Udu007/Automatic-Wire-Cutter/Hardware/wire_feeder_shaft.stl

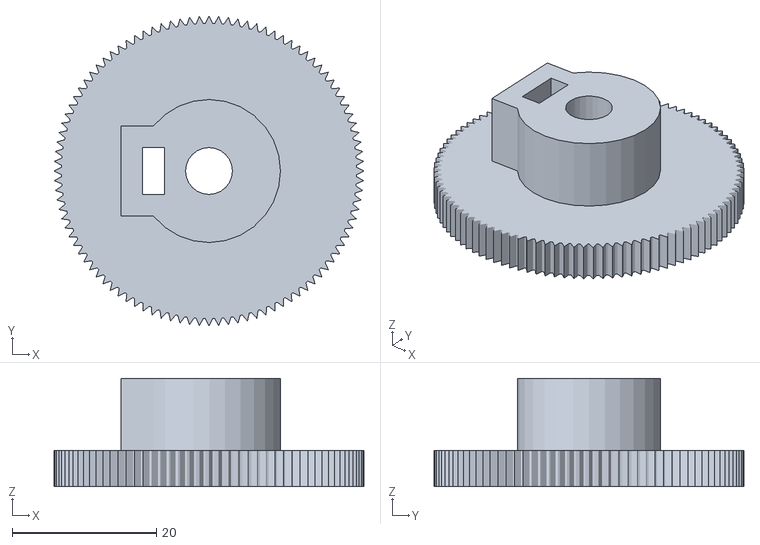
[picture p1: CAD file, 2026-06-25]
Hardware/wire_feeder_shaft.stl
43.0 x 43.0 x 15.0
