Udu007/Automatic-Wire-Cutter/Hardware/supporter.stl

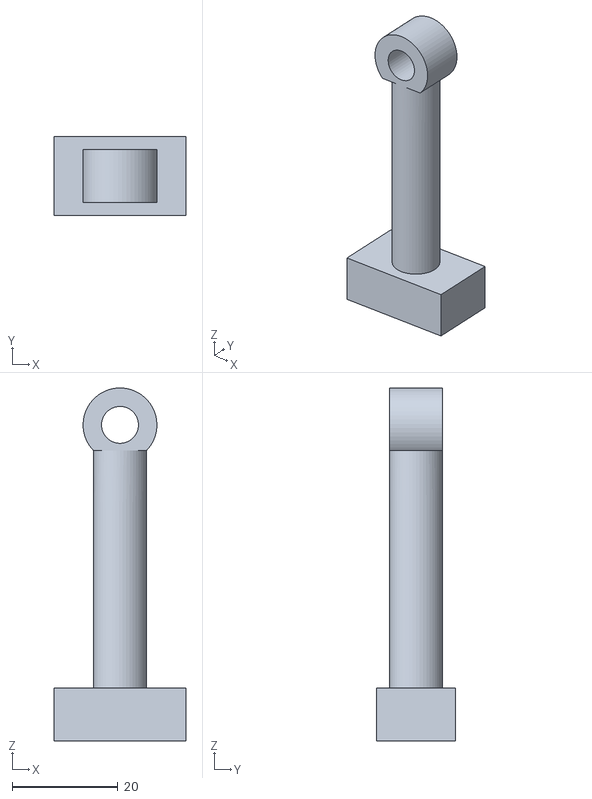
[picture p2: CAD file, 2026-06-25]
Hardware/supporter.stl
25.0 x 15.0 x 66.9
