Udu007/Automatic-Wire-Cutter/Hardware/wire_feeder_part2.stl

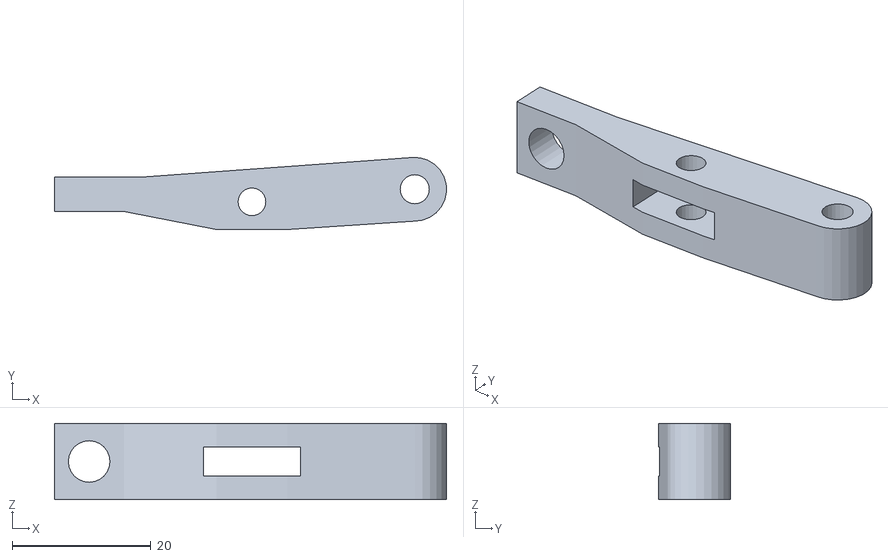
[picture p3: CAD file, 2026-06-25]
Hardware/wire_feeder_part2.stl
56.6 x 10.4 x 11.0
