Udu007/Automatic-Wire-Cutter/Hardware/Servo Guide.stl

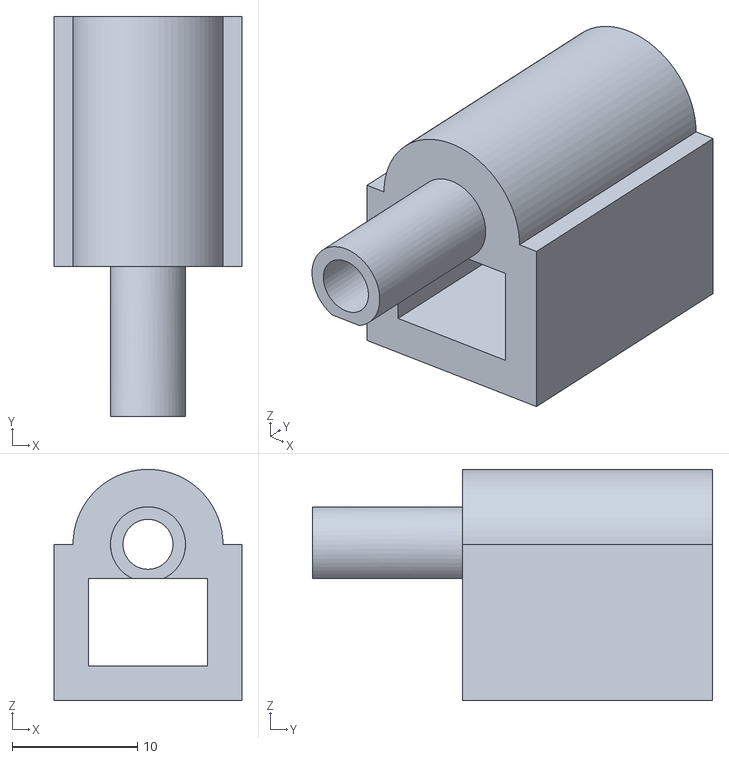
[picture p4: CAD file, 2026-06-25]
Hardware/Servo Guide.stl
15.0 x 32.0 x 18.5
