Udu007/Automatic-Wire-Cutter/Hardware/Wire Cutter Base Stand.stl

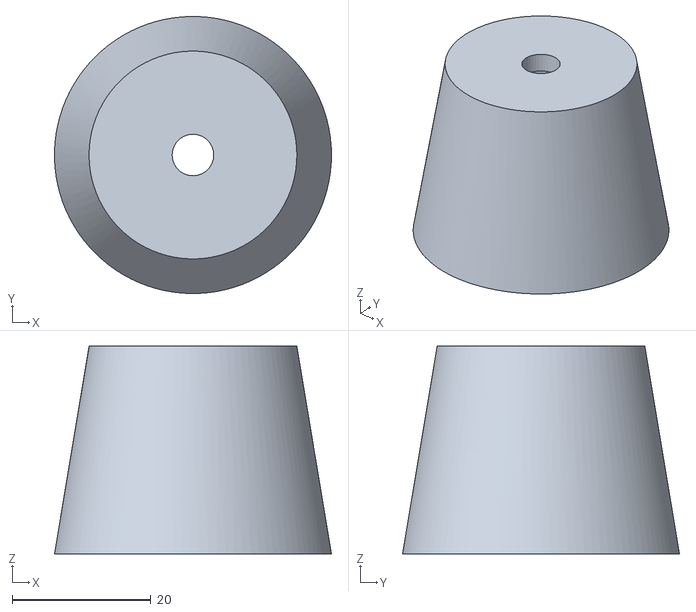
[picture p5: CAD file, 2026-06-25]
Hardware/Wire Cutter Base Stand.stl
40.0 x 40.0 x 30.0
