Udu007/Automatic-Wire-Cutter/Hardware/cutter_puller.stl

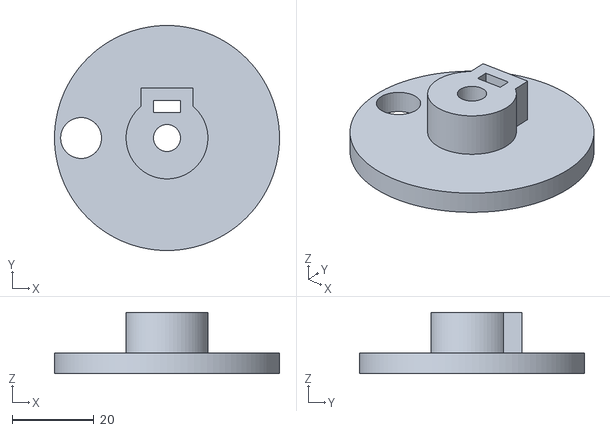
[picture p6: CAD file, 2026-06-25]
Hardware/cutter_puller.stl
55.0 x 55.0 x 15.0
