Udu007/Automatic-Wire-Cutter/Hardware/Wire Cutter Stand.stl

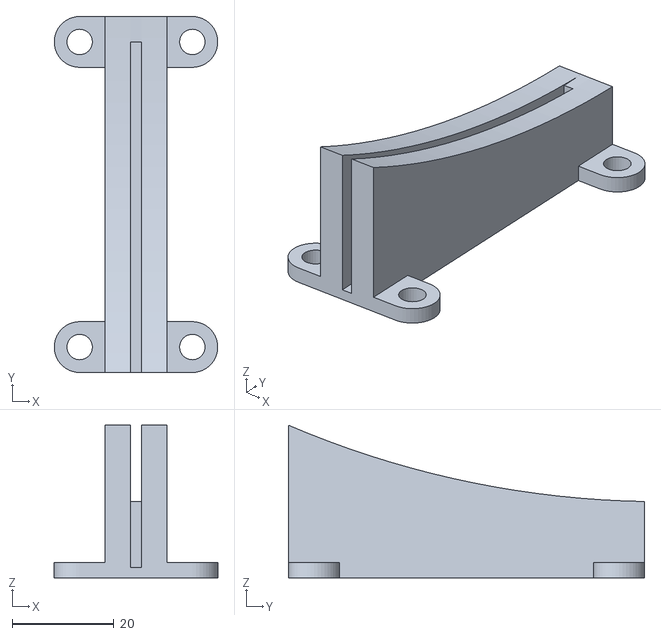
[picture p7: CAD file, 2026-06-25]
Hardware/Wire Cutter Stand.stl
32.2 x 70.0 x 30.0
