Udu007/Automatic-Wire-Cutter/Hardware/SMPS Stand.stl

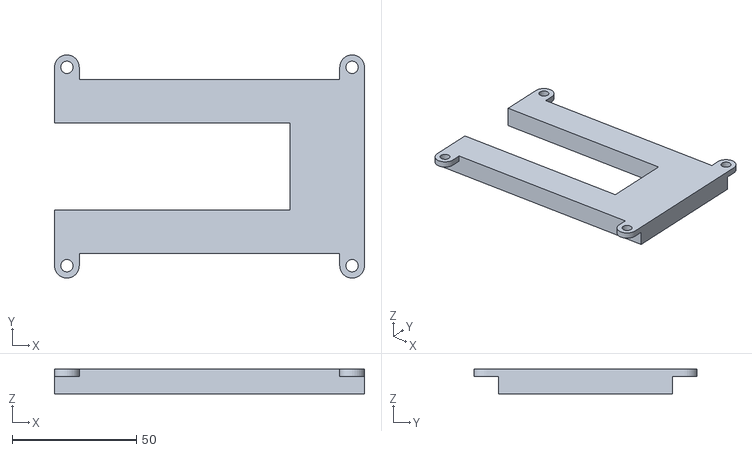
[picture p8: CAD file, 2026-06-25]
Hardware/SMPS Stand.stl
125.0 x 90.0 x 10.0
