Udu007/Automatic-Wire-Cutter/Hardware/Wire Puller Shaft.stl

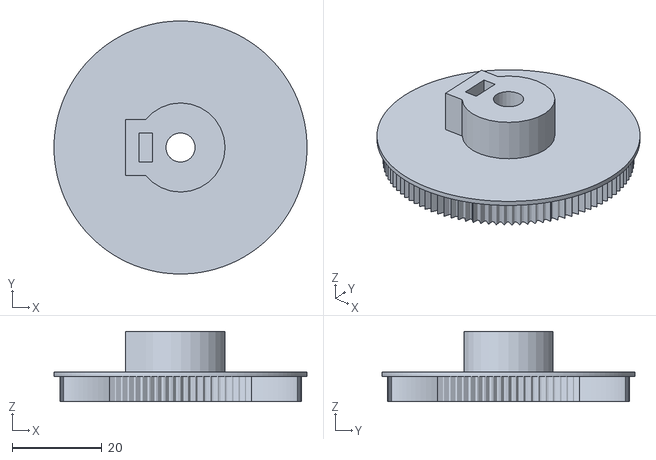
[picture p9: CAD file, 2026-06-25]
Hardware/Wire Puller Shaft.stl
56.3 x 56.3 x 15.6
