Udu007/Automatic-Wire-Cutter/(list of files, cad)

Other CAD files:
Hardware/Full Project.f3d
Hardware/SMPS Stand.f3d
Hardware/Wire Cutter Base Stand.f3d
Hardware/Wire Cutter Stand.f3d
Hardware/servo part.f3d
