Udu007/Automatic-Wire-Cutter/Hardware/Servo Guide Drawing.pdf

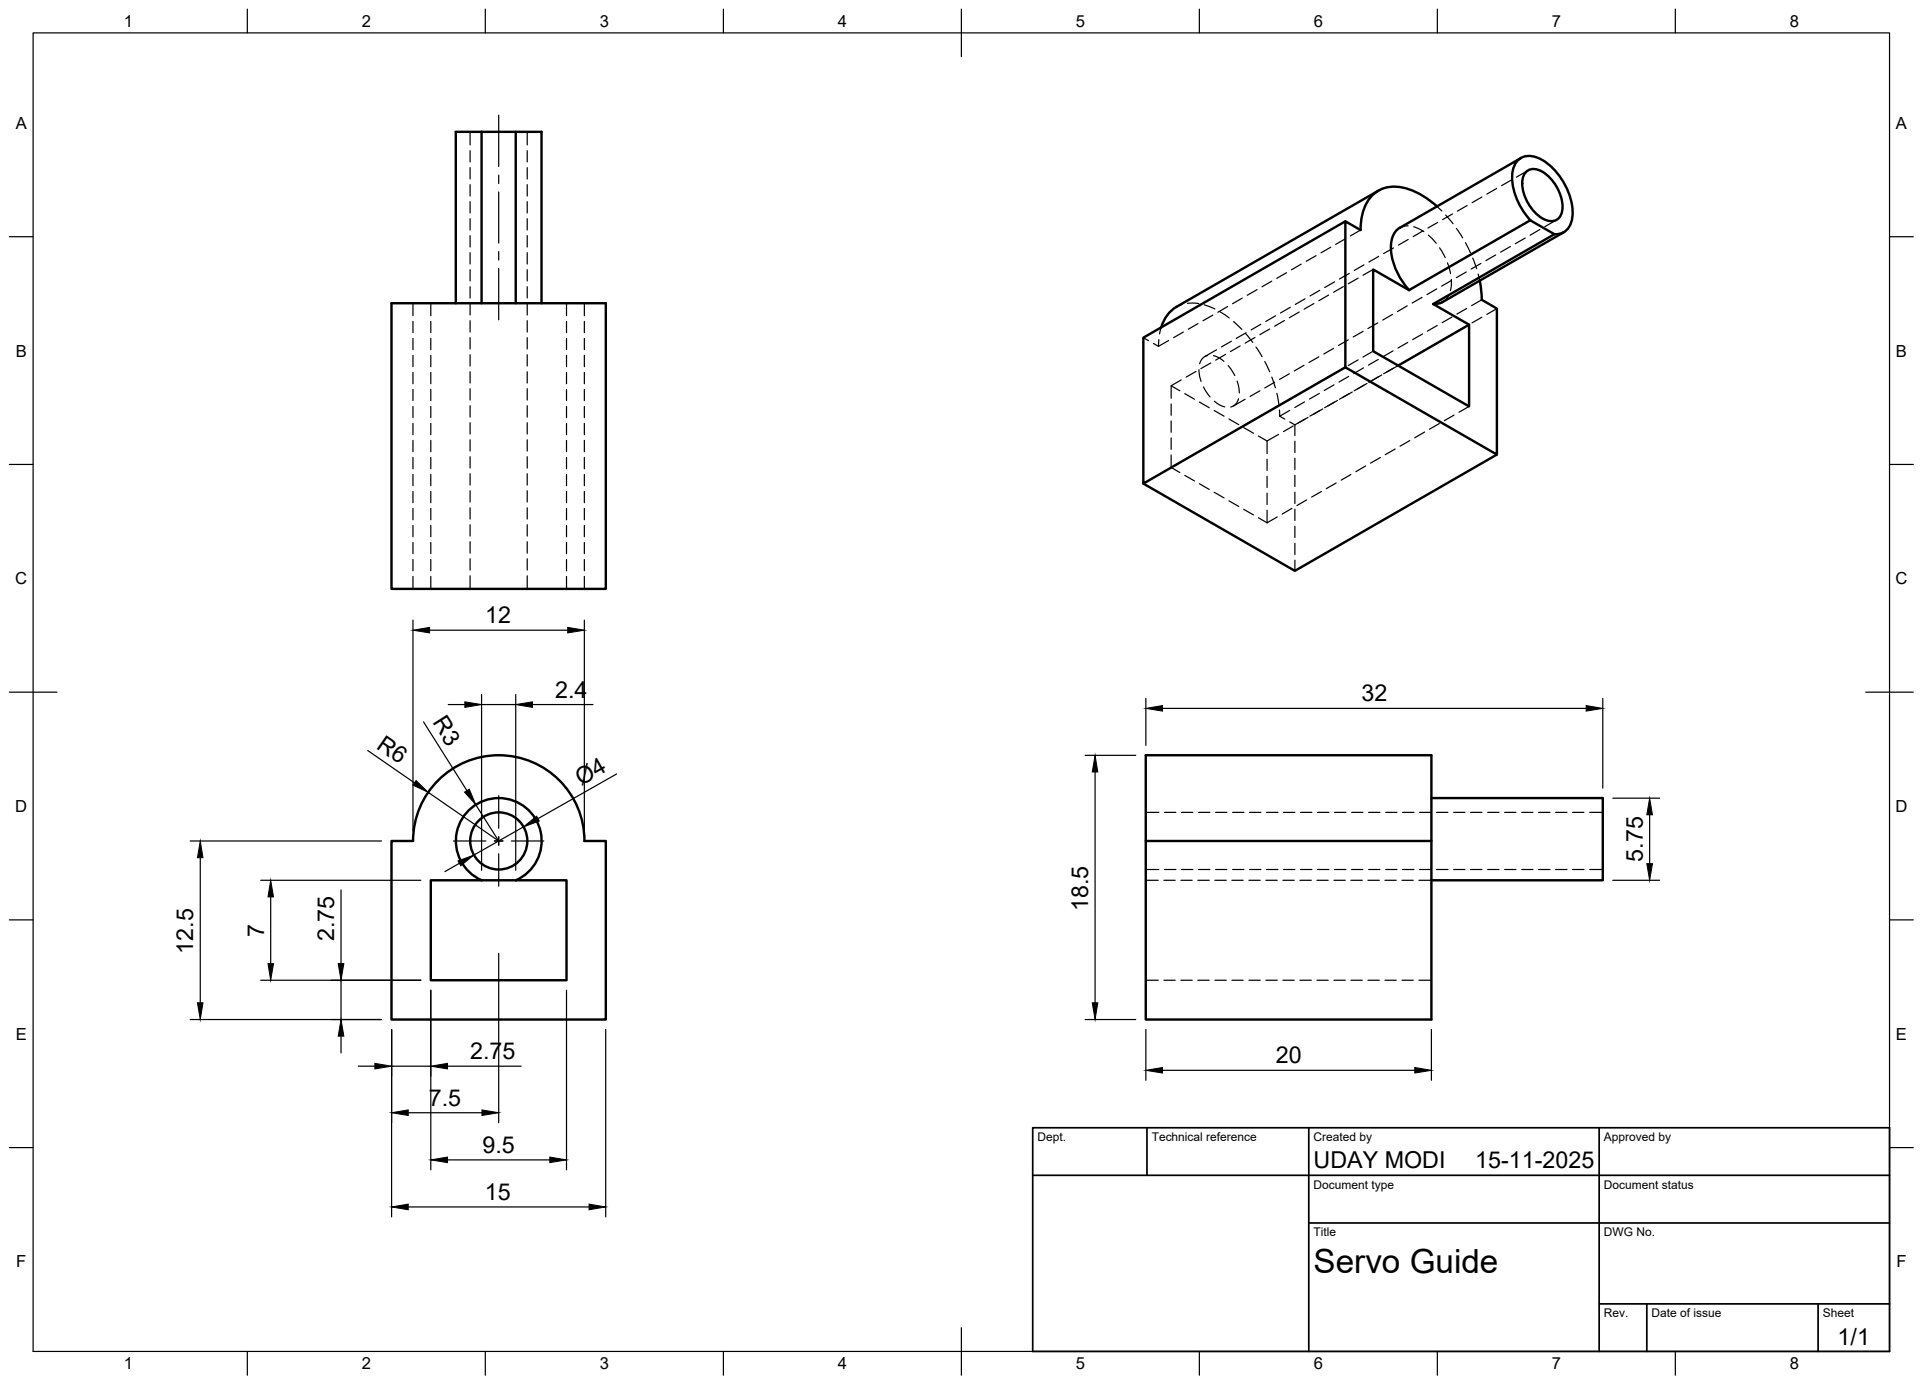
[picture p10: page 1]
Title; DWG No.; Rev.; Date of issue; Sheet; Servo Guide

Dept. | Technical reference | Created by UDAY MODI 15-11-2025 | Approved by

Document type | Document status
